dllud/lights_control/(list of files, drawings)

Other design files:
schematics/all_in_one.pcb
