dllud/lights_control/(commit log)

2013-07-18 Cleaned example usermod from the repo. Added finished schematic of the lights controlling device.
    [example.sch, lights_control.sch]
2013-07-18 Half-way in the system description in README.
    [lights_control.sch]
2013-07-19 Finished pre-development version of README. Added sketch of the operator interface. Component renaming in the schematic.
    [lights_control.sch]
2013-07-20 Rearranged port connectiosn in schematic (PB5 is used by Arduino's internal LED). Added a sketch of the module for manual control.
    [lights_control.sch]
2013-07-21 After physical testing increased maximum blink frequency from 50 Hz to 70 Hz.
2013-07-21 Changed blink timers to uint16 to allow lower frequencies. Changed interface to show an adjustable frequency of 1-30 Hz.
    [lights_control.sch]
2013-07-25 Added first snippet of code to control UV led blinking.
2013-07-26 FInished manual controller. Added empty files and functions for analyzer mode.
    [lights_control.sch]
2013-09-01 Schematic almost finished. All transistors and resistors are chosen.
    [lights_control.sch]
2013-09-02 In the schematic removed the unnecessary fixed resistor. Added a very basic module to control the lightning of the translucent box.
    [lights_control.sch]
2013-09-07 Connected ATmega's and power supply GND. Substituted resistors of white LEDs for others with higher values in order to decrease brightness. Mode module now lights up one LED during start-up.
    [lights_control.sch]
2013-09-08 Corrected logic error in reading of MODE push button. All push buttons now using the internal pull-up resistor.
    [lights_control.sch]
2013-09-08 Now using Phase Correct PWM Mode as Fast PWM would not allow to turn LEDs completely off.
    [box.c, main.c, ports.c, pwm.c]
2013-09-18 Extended the circuit in order to use an independent AVR microcontroller instead of an Arduino.
    [lights_control.sch]
2013-09-19 Added footprint for most components.
    [all_in_one.sch, lights_control.sch]
2013-09-20 Added a connector for the external LED strips.
    [all_in_one.sch]
2013-09-23 Substituted preset mode for a analyze sound and blink UV mode.
    [all_in_one.sch]
2013-09-24 Finished sound analyzer to blink UV. Dividing circuits into 2 boards: main and controls.
    [main.sch]
2013-09-25 Added schematic and preliminar pcb layout for the controls board.
    [controls.pcb, controls.sch, main.sch]
2013-09-26 Went back to a single board. Reason: with two board there was the need to have a lot of wires (> 15) connecting them.
    [all_in_one.pcb, all_in_one.sch, controls.pcb, controls.sch, main.sch]
2013-09-28 Added custom symbols for the various transistors used. Now all elements are connected by rat lines in the PCB layout.
    [all_in_one.pcb, all_in_one.sch]
2013-10-01 Finished PCB elements for push buttons.
    [all_in_one.pcb, all_in_one.sch]
2013-10-02 Added custom symbol for ATmega8 series. PCB layout with elements almost in their final positions.
    [all_in_one.pcb, all_in_one.sch]
2013-10-02 Updated README. Added first real lines in PCB layout.
    [all_in_one.pcb]
2013-10-03 PCB layout almost finished. All components are now connected.
    [all_in_one.pcb, all_in_one.sch]
2013-10-08 Edited pins of resistor's footprints.
    [all_in_one.pcb, all_in_one.sch]
2013-10-21 Custom board programming now supported in the Makefile. Substituted 3A transistors for TIP31C.
    [all_in_one.pcb, all_in_one.sch]
2013-10-26 Added attributions to symbols and footprints.
2014-05-09 Added footprints for some remaning components. Footprints were based on measurements of the real hardware. PCB is now double-layered, jumpers removed.
    [all_in_one.pcb, all_in_one.sch]
2014-05-09 Added heatsink to the schematics and PCB design.
    [all_in_one.pcb, all_in_one.sch]
