dllud/lights_control/(notices)

Notices in the files:
sysmods/pwm.c:
This program is free software; you can redistribute it and/or modify
it under the terms of the GNU General Public License Version 3 as
published by the Free Software Foundation.
